Antgenix1/Elevator/3D-printables/Elevator_Display_Assembly.step

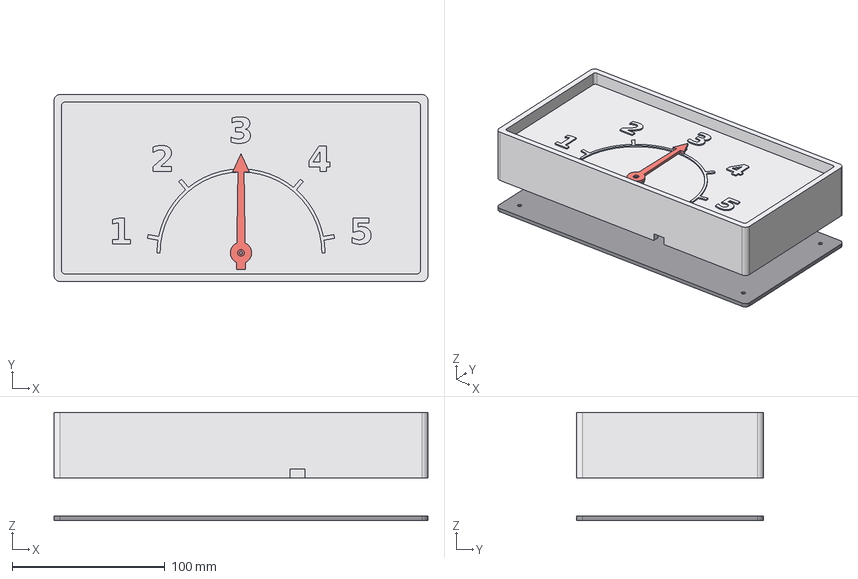
[picture p7: CAD file, 2026-11-10]
3D-printables/Elevator_Display_Assembly.step
245.0 x 122.5 x 71.0 mm
Housing
Needle
Back_Cover
