Antgenix1/Elevator/3D-printables/Slicer.3mf

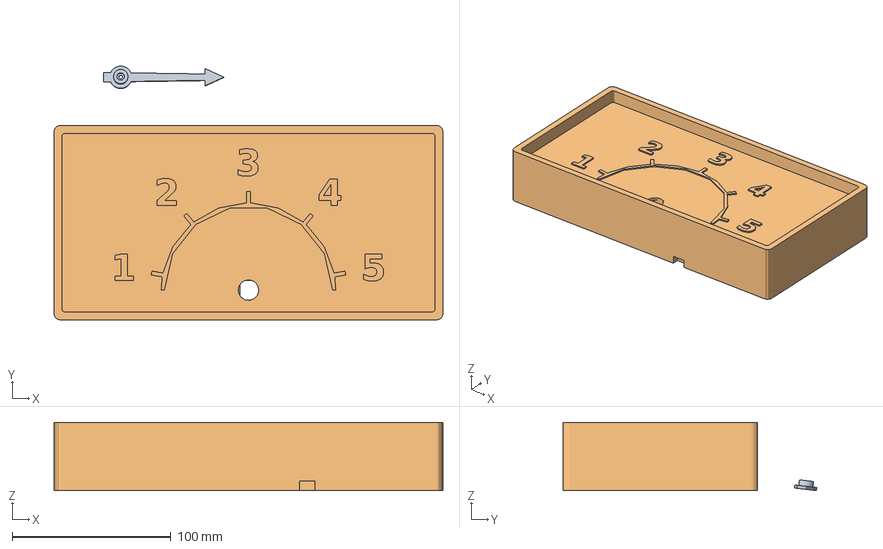
[picture p8: CAD file, 2026-11-10]
3D-printables/Slicer.3mf
245.0 x 159.8 x 43.0 mm
Needle
Untitled_Project
