Antgenix1/Elevator/3D-printables/Housing.step

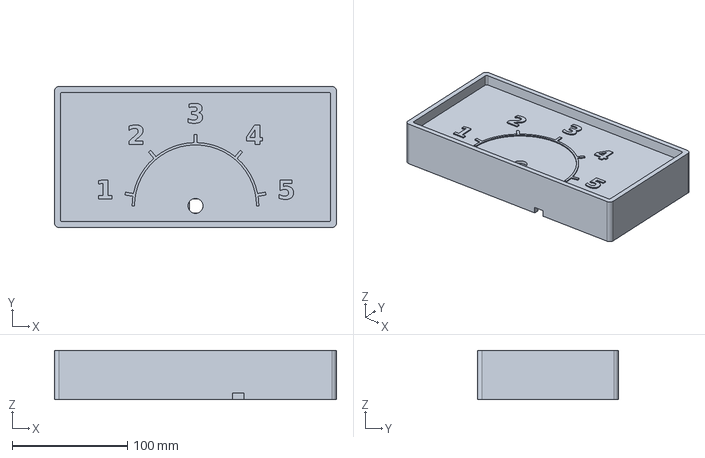
[picture p9: CAD file, 2026-11-10]
3D-printables/Housing.step
245.0 x 122.5 x 43.0 mm
