Antgenix1/Elevator/3D-printables/Needle.step

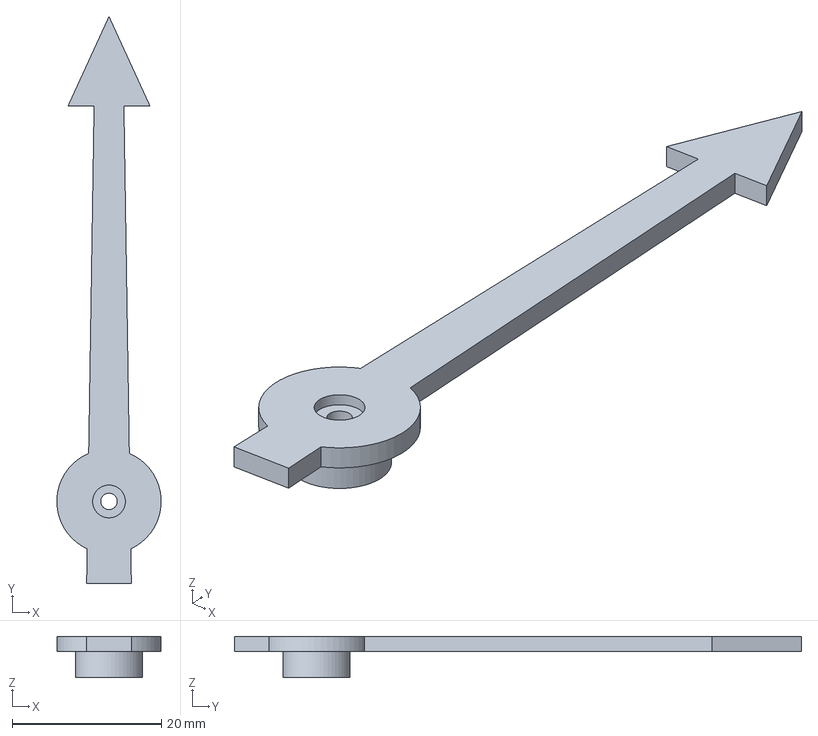
[picture p10: CAD file, 2026-11-10]
3D-printables/Needle.step
14.0 x 76.0 x 5.50 mm
