Antgenix1/Elevator/3D-printables/Back_Cover.step

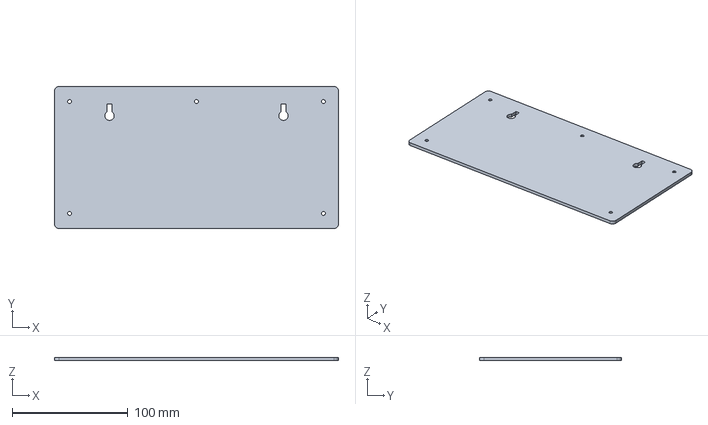
[picture p11: CAD file, 2026-11-10]
3D-printables/Back_Cover.step
245.0 x 122.5 x 3.00 mm
